msfoley/keyboard/keyboard.kicad_sch

## KiCad design keyboard.kicad_sch (2024-04-20)

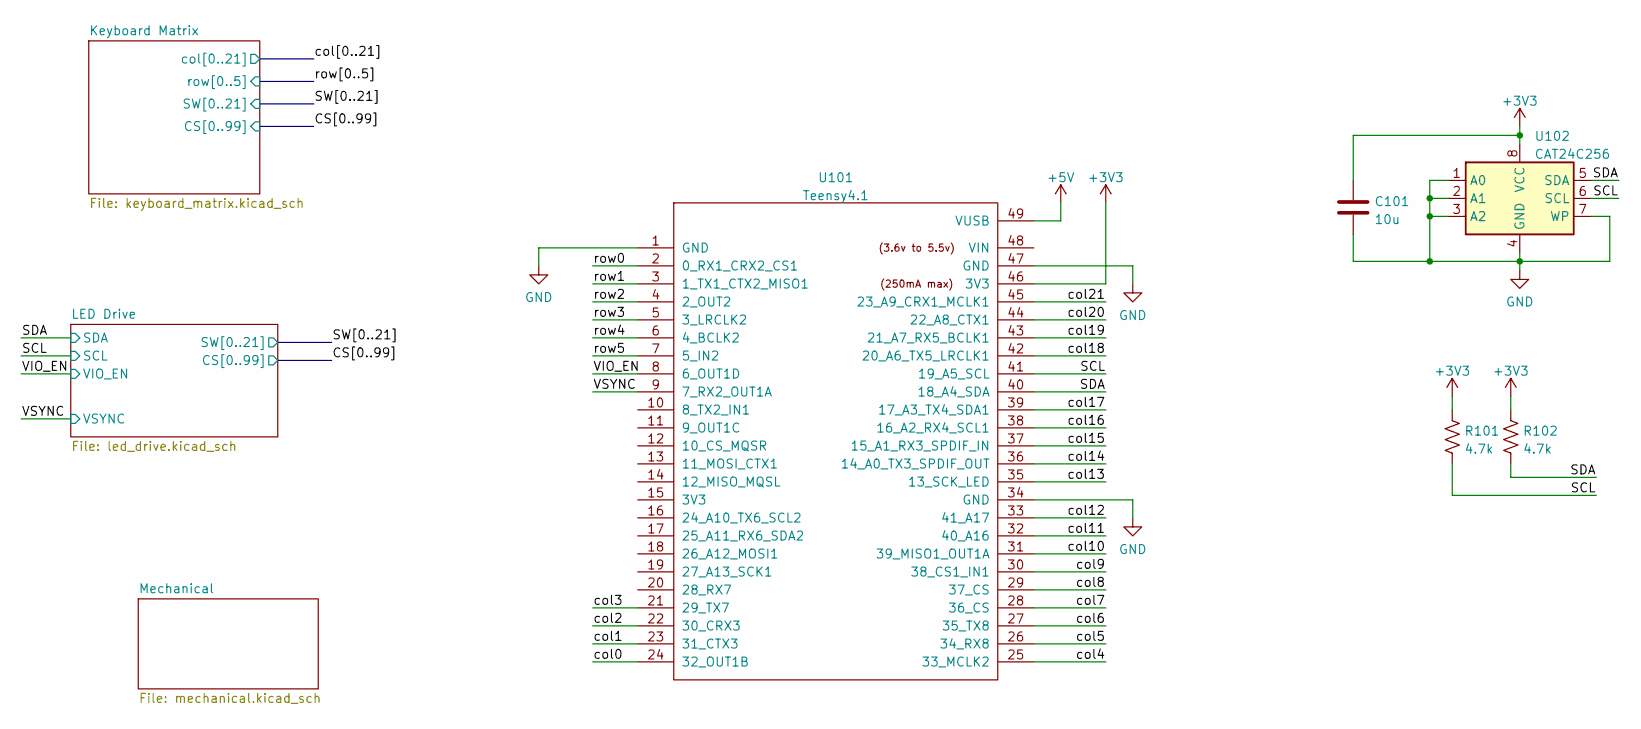
[picture p1: schematic keyboard.kicad_sch]

Parts:
C101: 10u; C_0805_2012Metric
R101, R102: 4.7k; R_0805_2012Metric
U101: Teensy4.1; Teensy41
U102: CAT24C256; TSSOP-8_4.4x3mm_P0.65mm

Connections:
+3V3: C101.1, R101.1, R102.1, U101.46 (3V3), U102.8 (VCC)
+5V: U101.49 (VUSB)
GND: C101.2, U101.1 (GND), U101.34 (GND), U101.47 (GND), U102.1 (A0), U102.2 (A1), U102.3 (A2), U102.4 (GND), U102.7 (WP)
SCL: R101.2, U101.41 (19_A5_SCL), U102.6 (SCL)
SDA: R102.2, U101.40 (18_A4_SDA), U102.5 (SDA)
VIO_EN: U101.8 (6_OUT1D)
VSYNC: U101.9 (7_RX2_OUT1A)
col0: U101.24 (32_OUT1B)
col1: U101.23 (31_CTX3)
col2: U101.22 (30_CRX3)
col3: U101.21 (29_TX7)
col4: U101.25 (33_MCLK2)
col5: U101.26 (34_RX8)
col6: U101.27 (35_TX8)
col7: U101.28 (36_CS)
col8: U101.29 (37_CS)
col9: U101.30 (38_CS1_IN1)
col10: U101.31 (39_MISO1_OUT1A)
col11: U101.32 (40_A16)
col12: U101.33 (41_A17)
col13: U101.35 (13_SCK_LED)
col14: U101.36 (14_A0_TX3_SPDIF_OUT)
col15: U101.37 (15_A1_RX3_SPDIF_IN)
col16: U101.38 (16_A2_RX4_SCL1)
col17: U101.39 (17_A3_TX4_SDA1)
col18: U101.42 (20_A6_TX5_LRCLK1)
col19: U101.43 (21_A7_RX5_BCLK1)
col20: U101.44 (22_A8_CTX1)
col21: U101.45 (23_A9_CRX1_MCLK1)
row0: U101.2 (0_RX1_CRX2_CS1)
row1: U101.3 (1_TX1_CTX2_MISO1)
row2: U101.4 (2_OUT2)
row3: U101.5 (3_LRCLK2)
row4: U101.6 (4_BCLK2)
row5: U101.7 (5_IN2)
