msfoley/keyboard/keyboard_matrix.kicad_sch

## KiCad design keyboard_matrix.kicad_sch (2024-04-20)

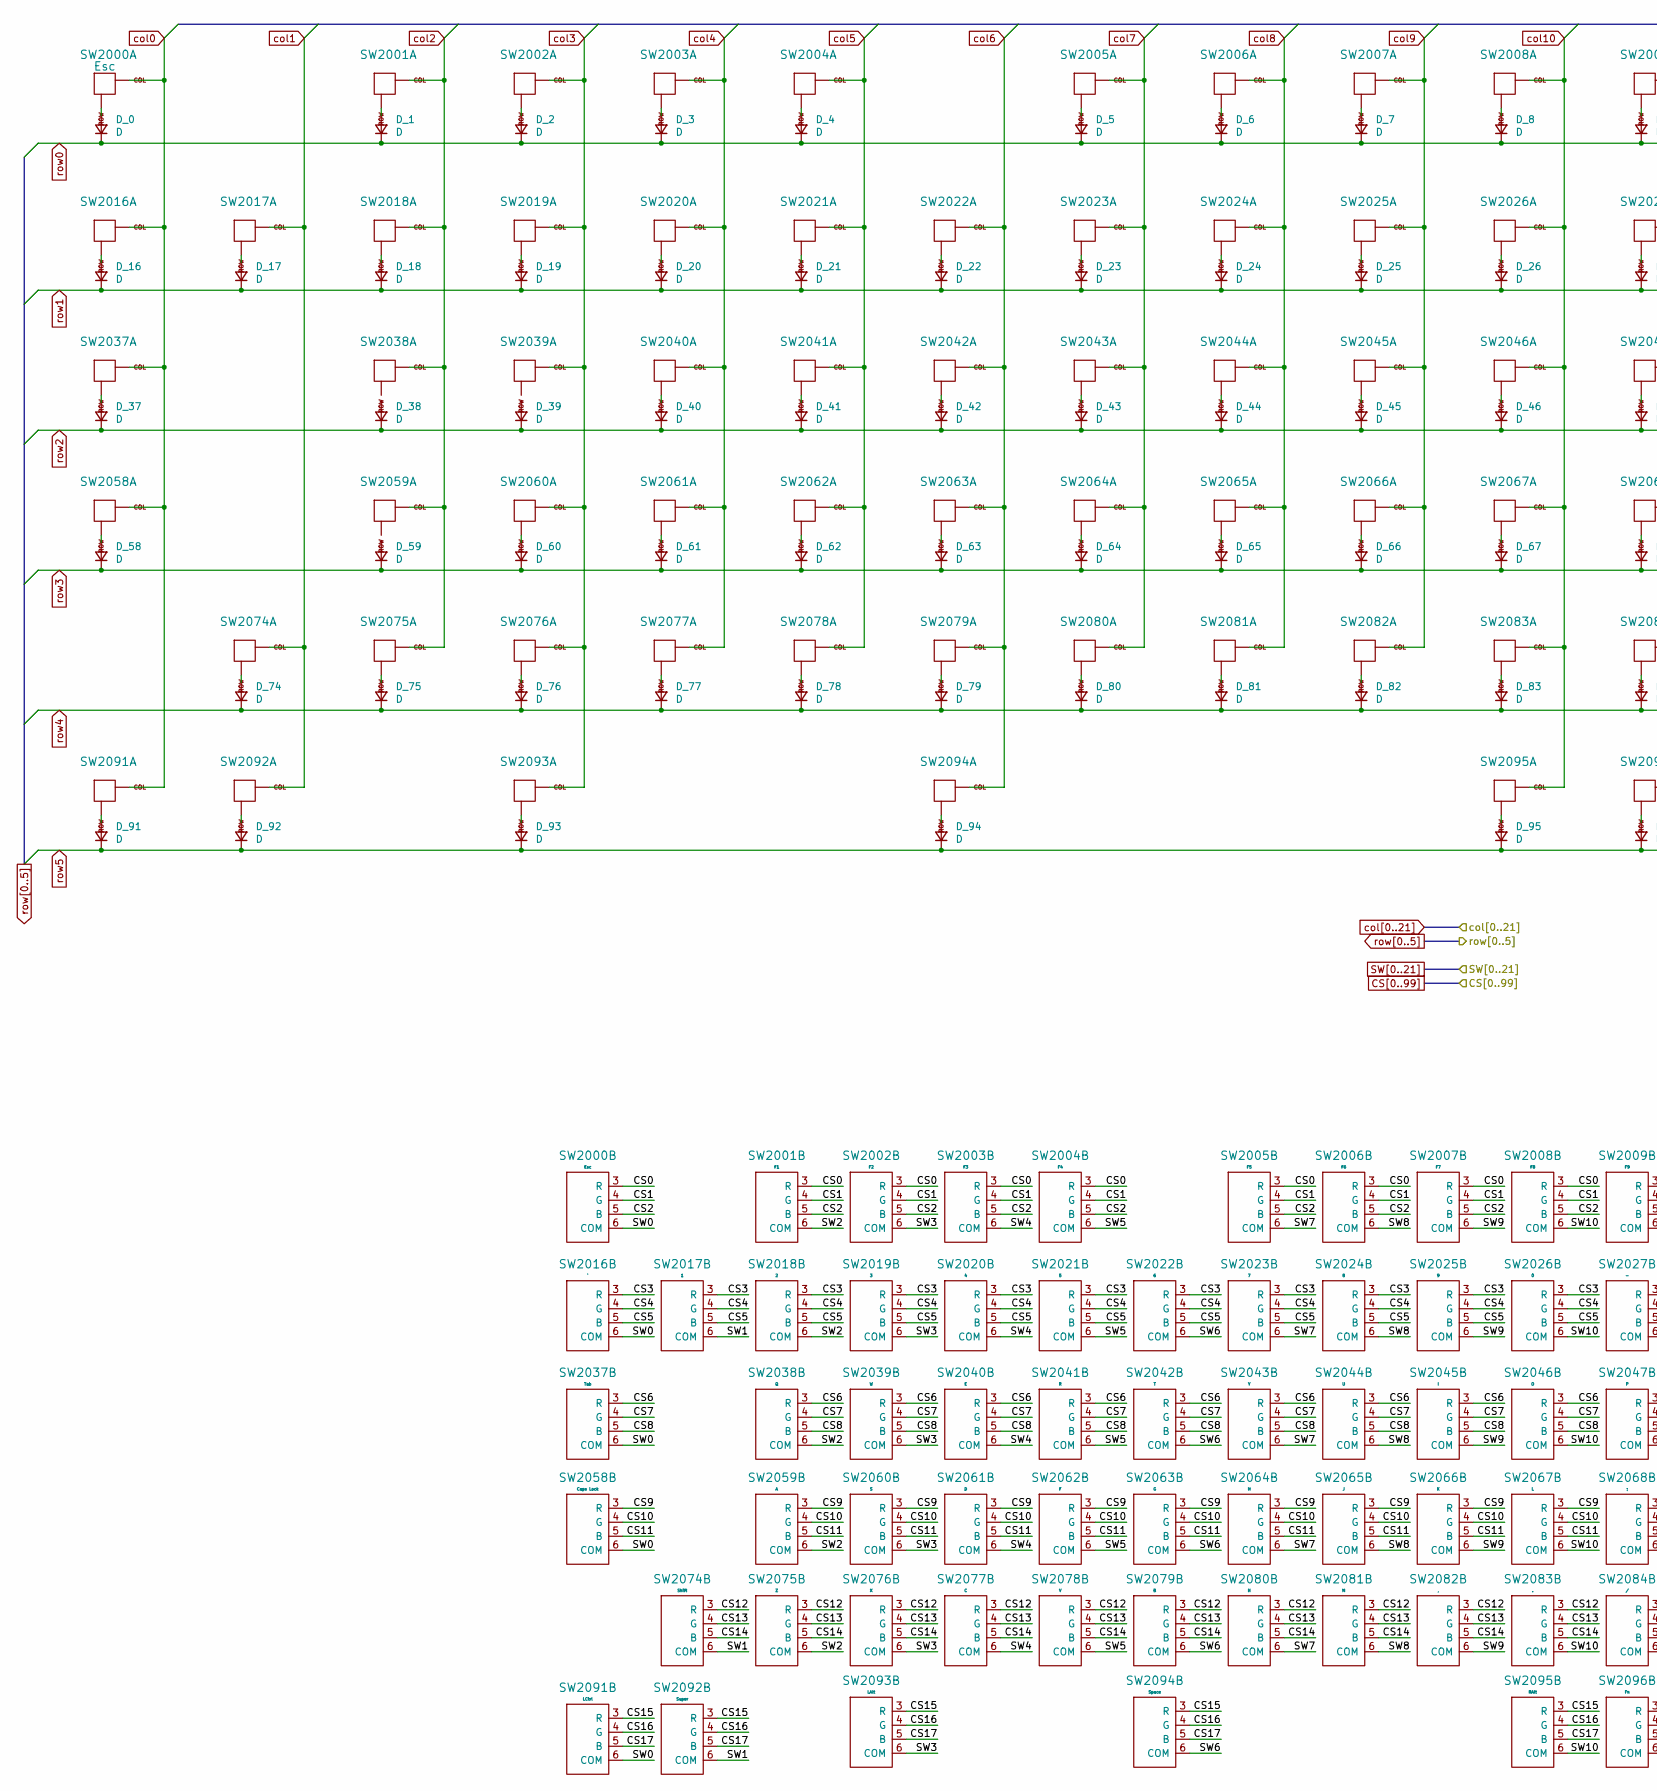
[picture p2: schematic keyboard_matrix.kicad_sch, part in row 1, column 1]

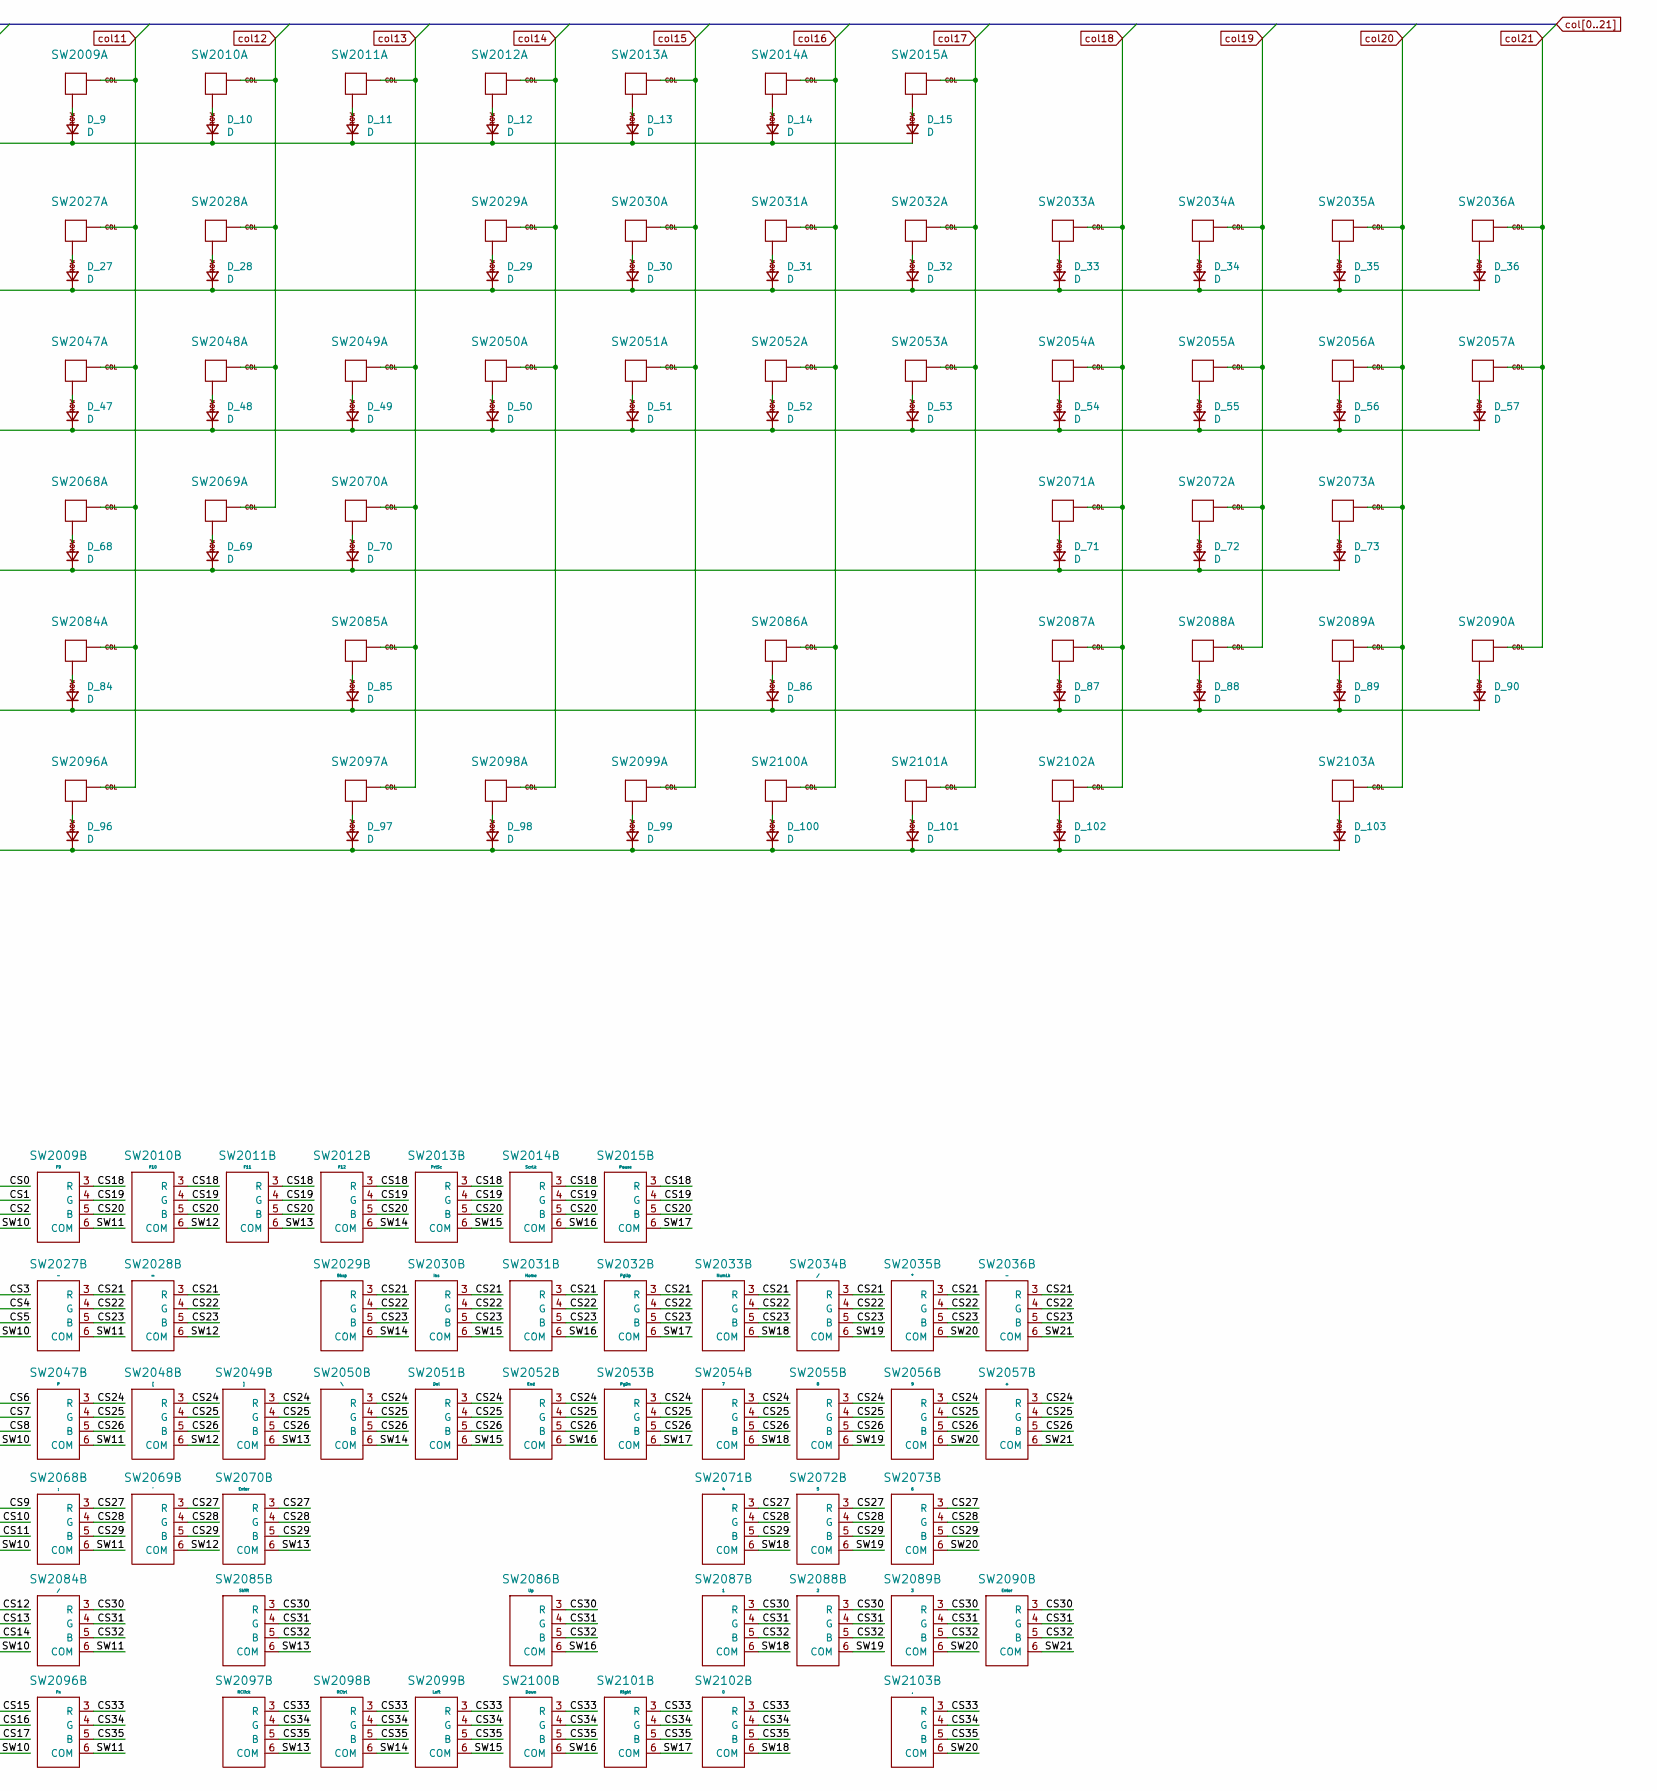
[picture p3: schematic keyboard_matrix.kicad_sch, part in row 1, column 2]

Parts:
D_0, D_1, D_2, D_3, D_4, D_5, D_6, D_7, D_8, D_9, D_10, D_11, D_12, D_13, D_14, D_15, D_16, D_17, D_18, D_19, D_20, D_21, D_22, D_23, D_24, D_25, D_26, D_27, D_28, D_29, D_30, D_31, D_32, D_33, D_34, D_35, D_36, D_37, D_38, D_39, D_40, D_41, D_42, D_43, D_44, D_45, D_46, D_47, D_48, D_49, D_50, D_51, D_52, D_53, D_54, D_55, D_56, D_57, D_58, D_59, D_60, D_61, D_62, D_63, D_64, D_65, D_66, D_67, D_68, D_69, D_70, D_71, D_72, D_73, D_74, D_75, D_76, D_77, D_78, D_79, D_80, D_81, D_82, D_83, D_84, D_85, D_86, D_87, D_88, D_89, D_90, D_91, D_92, D_93, D_94, D_95, D_96, D_97, D_98, D_99, D_100, D_101, D_102, D_103: D; D_SOD-123
SW2000: Esc; MXOnly-1U-Hotswap
SW2001: F1; MXOnly-1U-Hotswap
SW2002: F2; MXOnly-1U-Hotswap
SW2003: F3; MXOnly-1U-Hotswap
SW2004: F4; MXOnly-1U-Hotswap
SW2005: F5; MXOnly-1U-Hotswap
SW2006: F6; MXOnly-1U-Hotswap
SW2007: F7; MXOnly-1U-Hotswap
SW2008: F8; MXOnly-1U-Hotswap
SW2009: F9; MXOnly-1U-Hotswap
SW2010: F10; MXOnly-1U-Hotswap
SW2011: F11; MXOnly-1U-Hotswap
SW2012: F12; MXOnly-1U-Hotswap
SW2013: PrtSc; MXOnly-1U-Hotswap
SW2014: ScrLk; MXOnly-1U-Hotswap
SW2015: Pause; MXOnly-1U-Hotswap
SW2016: `; MXOnly-1U-Hotswap
SW2017, SW2087: 1; MXOnly-1U-Hotswap
SW2018, SW2088: 2; MXOnly-1U-Hotswap
SW2019, SW2089: 3; MXOnly-1U-Hotswap
SW2020, SW2071: 4; MXOnly-1U-Hotswap
SW2021, SW2072: 5; MXOnly-1U-Hotswap
SW2022, SW2073: 6; MXOnly-1U-Hotswap
SW2023, SW2054: 7; MXOnly-1U-Hotswap
SW2024, SW2055: 8; MXOnly-1U-Hotswap
SW2025, SW2056: 9; MXOnly-1U-Hotswap
SW2026, SW2102: 0; MXOnly-1U-Hotswap
SW2027, SW2036: -; MXOnly-1U-Hotswap
SW2028: =; MXOnly-1U-Hotswap
SW2029: Bksp; MXOnly-2U-Hotswap
SW2030: Ins; MXOnly-1U-Hotswap
SW2031: Home; MXOnly-1U-Hotswap
SW2032: PgUp; MXOnly-1U-Hotswap
SW2033: NumLk; MXOnly-1U-Hotswap
SW2034, SW2084: /; MXOnly-1U-Hotswap
SW2035: *; MXOnly-1U-Hotswap
SW2037: Tab; MXOnly-1.5U-Hotswap
SW2038: Q; MXOnly-1U-Hotswap
SW2039: W; MXOnly-1U-Hotswap
SW2040: E; MXOnly-1U-Hotswap
SW2041: R; MXOnly-1U-Hotswap
SW2042: T; MXOnly-1U-Hotswap
SW2043: Y; MXOnly-1U-Hotswap
SW2044: U; MXOnly-1U-Hotswap
SW2045: I; MXOnly-1U-Hotswap
SW2046: O; MXOnly-1U-Hotswap
SW2047: P; MXOnly-1U-Hotswap
SW2048: [; MXOnly-1U-Hotswap
SW2049: ]; MXOnly-1U-Hotswap
SW2050: \; MXOnly-1.5U-Hotswap
SW2051: Del; MXOnly-1U-Hotswap
SW2052: End; MXOnly-1U-Hotswap
SW2053: PgDn; MXOnly-1U-Hotswap
SW2057: +; MXOnly-2U-Hotswap
SW2058: Caps Lock; MXOnly-1.75U-Hotswap
SW2059: A; MXOnly-1U-Hotswap
SW2060: S; MXOnly-1U-Hotswap
SW2061: D; MXOnly-1U-Hotswap
SW2062: F; MXOnly-1U-Hotswap
SW2063: G; MXOnly-1U-Hotswap
SW2064: H; MXOnly-1U-Hotswap
SW2065: J; MXOnly-1U-Hotswap
SW2066: K; MXOnly-1U-Hotswap
SW2067: L; MXOnly-1U-Hotswap
SW2068: ;; MXOnly-1U-Hotswap
SW2069: '; MXOnly-1U-Hotswap
SW2070: Enter; MXOnly-2.25U-Hotswap
SW2074: Shift; MXOnly-2.25U-Hotswap
SW2075: Z; MXOnly-1U-Hotswap
SW2076: X; MXOnly-1U-Hotswap
SW2077: C; MXOnly-1U-Hotswap
SW2078: V; MXOnly-1U-Hotswap
SW2079: B; MXOnly-1U-Hotswap
SW2080: N; MXOnly-1U-Hotswap
SW2081: M; MXOnly-1U-Hotswap
SW2082: ,; MXOnly-1U-Hotswap
SW2083, SW2103: .; MXOnly-1U-Hotswap
SW2085: Shift; MXOnly-2.75U-Hotswap
SW2086: Up; MXOnly-1U-Hotswap
SW2090: Enter; MXOnly-2U-Hotswap
SW2091: LCtrl; MXOnly-1U-Hotswap
SW2092: Super; MXOnly-1U-Hotswap
SW2093: LAlt; MXOnly-1U-Hotswap
SW2094: Space; MXOnly-6.25U-Hotswap
SW2095: RAlt; MXOnly-1U-Hotswap
SW2096: Fn; MXOnly-1U-Hotswap
SW2097: RClick; MXOnly-1U-Hotswap
SW2098: RCtrl; MXOnly-1U-Hotswap
SW2099: Left; MXOnly-1U-Hotswap
SW2100: Down; MXOnly-1U-Hotswap
SW2101: Right; MXOnly-1U-Hotswap

Connections:
CS0: SW2000.3 (R), SW2001.3 (R), SW2002.3 (R), SW2003.3 (R), SW2004.3 (R), SW2005.3 (R), SW2006.3 (R), SW2007.3 (R), SW2008.3 (R)
CS1: SW2000.4 (G), SW2001.4 (G), SW2002.4 (G), SW2003.4 (G), SW2004.4 (G), SW2005.4 (G), SW2006.4 (G), SW2007.4 (G), SW2008.4 (G)
CS2: SW2000.5 (B), SW2001.5 (B), SW2002.5 (B), SW2003.5 (B), SW2004.5 (B), SW2005.5 (B), SW2006.5 (B), SW2007.5 (B), SW2008.5 (B)
CS3: SW2016.3 (R), SW2017.3 (R), SW2018.3 (R), SW2019.3 (R), SW2020.3 (R), SW2021.3 (R), SW2022.3 (R), SW2023.3 (R), SW2024.3 (R), SW2025.3 (R), SW2026.3 (R)
CS4: SW2016.4 (G), SW2017.4 (G), SW2018.4 (G), SW2019.4 (G), SW2020.4 (G), SW2021.4 (G), SW2022.4 (G), SW2023.4 (G), SW2024.4 (G), SW2025.4 (G), SW2026.4 (G)
CS5: SW2016.5 (B), SW2017.5 (B), SW2018.5 (B), SW2019.5 (B), SW2020.5 (B), SW2021.5 (B), SW2022.5 (B), SW2023.5 (B), SW2024.5 (B), SW2025.5 (B), SW2026.5 (B)
CS6: SW2037.3 (R), SW2038.3 (R), SW2039.3 (R), SW2040.3 (R), SW2041.3 (R), SW2042.3 (R), SW2043.3 (R), SW2044.3 (R), SW2045.3 (R), SW2046.3 (R)
CS7: SW2037.4 (G), SW2038.4 (G), SW2039.4 (G), SW2040.4 (G), SW2041.4 (G), SW2042.4 (G), SW2043.4 (G), SW2044.4 (G), SW2045.4 (G), SW2046.4 (G)
CS8: SW2037.5 (B), SW2038.5 (B), SW2039.5 (B), SW2040.5 (B), SW2041.5 (B), SW2042.5 (B), SW2043.5 (B), SW2044.5 (B), SW2045.5 (B), SW2046.5 (B)
CS9: SW2058.3 (R), SW2059.3 (R), SW2060.3 (R), SW2061.3 (R), SW2062.3 (R), SW2063.3 (R), SW2064.3 (R), SW2065.3 (R), SW2066.3 (R), SW2067.3 (R)
CS10: SW2058.4 (G), SW2059.4 (G), SW2060.4 (G), SW2061.4 (G), SW2062.4 (G), SW2063.4 (G), SW2064.4 (G), SW2065.4 (G), SW2066.4 (G), SW2067.4 (G)
CS11: SW2058.5 (B), SW2059.5 (B), SW2060.5 (B), SW2061.5 (B), SW2062.5 (B), SW2063.5 (B), SW2064.5 (B), SW2065.5 (B), SW2066.5 (B), SW2067.5 (B)
CS12: SW2074.3 (R), SW2075.3 (R), SW2076.3 (R), SW2077.3 (R), SW2078.3 (R), SW2079.3 (R), SW2080.3 (R), SW2081.3 (R), SW2082.3 (R), SW2083.3 (R)
CS13: SW2074.4 (G), SW2075.4 (G), SW2076.4 (G), SW2077.4 (G), SW2078.4 (G), SW2079.4 (G), SW2080.4 (G), SW2081.4 (G), SW2082.4 (G), SW2083.4 (G)
CS14: SW2074.5 (B), SW2075.5 (B), SW2076.5 (B), SW2077.5 (B), SW2078.5 (B), SW2079.5 (B), SW2080.5 (B), SW2081.5 (B), SW2082.5 (B), SW2083.5 (B)
CS15: SW2091.3 (R), SW2092.3 (R), SW2093.3 (R), SW2094.3 (R), SW2095.3 (R)
CS16: SW2091.4 (G), SW2092.4 (G), SW2093.4 (G), SW2094.4 (G), SW2095.4 (G)
CS17: SW2091.5 (B), SW2092.5 (B), SW2093.5 (B), SW2094.5 (B), SW2095.5 (B)
CS18: SW2009.3 (R), SW2010.3 (R), SW2011.3 (R), SW2012.3 (R), SW2013.3 (R), SW2014.3 (R), SW2015.3 (R)
CS19: SW2009.4 (G), SW2010.4 (G), SW2011.4 (G), SW2012.4 (G), SW2013.4 (G), SW2014.4 (G), SW2015.4 (G)
CS20: SW2009.5 (B), SW2010.5 (B), SW2011.5 (B), SW2012.5 (B), SW2013.5 (B), SW2014.5 (B), SW2015.5 (B)
CS21: SW2027.3 (R), SW2028.3 (R), SW2029.3 (R), SW2030.3 (R), SW2031.3 (R), SW2032.3 (R), SW2033.3 (R), SW2034.3 (R), SW2035.3 (R), SW2036.3 (R)
CS22: SW2027.4 (G), SW2028.4 (G), SW2029.4 (G), SW2030.4 (G), SW2031.4 (G), SW2032.4 (G), SW2033.4 (G), SW2034.4 (G), SW2035.4 (G), SW2036.4 (G)
CS23: SW2027.5 (B), SW2028.5 (B), SW2029.5 (B), SW2030.5 (B), SW2031.5 (B), SW2032.5 (B), SW2033.5 (B), SW2034.5 (B), SW2035.5 (B), SW2036.5 (B)
CS24: SW2047.3 (R), SW2048.3 (R), SW2049.3 (R), SW2050.3 (R), SW2051.3 (R), SW2052.3 (R), SW2053.3 (R), SW2054.3 (R), SW2055.3 (R), SW2056.3 (R), SW2057.3 (R)
CS25: SW2047.4 (G), SW2048.4 (G), SW2049.4 (G), SW2050.4 (G), SW2051.4 (G), SW2052.4 (G), SW2053.4 (G), SW2054.4 (G), SW2055.4 (G), SW2056.4 (G), SW2057.4 (G)
CS26: SW2047.5 (B), SW2048.5 (B), SW2049.5 (B), SW2050.5 (B), SW2051.5 (B), SW2052.5 (B), SW2053.5 (B), SW2054.5 (B), SW2055.5 (B), SW2056.5 (B), SW2057.5 (B)
CS27: SW2068.3 (R), SW2069.3 (R), SW2070.3 (R), SW2071.3 (R), SW2072.3 (R), SW2073.3 (R)
CS28: SW2068.4 (G), SW2069.4 (G), SW2070.4 (G), SW2071.4 (G), SW2072.4 (G), SW2073.4 (G)
CS29: SW2068.5 (B), SW2069.5 (B), SW2070.5 (B), SW2071.5 (B), SW2072.5 (B), SW2073.5 (B)
CS30: SW2084.3 (R), SW2085.3 (R), SW2086.3 (R), SW2087.3 (R), SW2088.3 (R), SW2089.3 (R), SW2090.3 (R)
CS31: SW2084.4 (G), SW2085.4 (G), SW2086.4 (G), SW2087.4 (G), SW2088.4 (G), SW2089.4 (G), SW2090.4 (G)
CS32: SW2084.5 (B), SW2085.5 (B), SW2086.5 (B), SW2087.5 (B), SW2088.5 (B), SW2089.5 (B), SW2090.5 (B)
CS33: SW2096.3 (R), SW2097.3 (R), SW2098.3 (R), SW2099.3 (R), SW2100.3 (R), SW2101.3 (R), SW2102.3 (R), SW2103.3 (R)
CS34: SW2096.4 (G), SW2097.4 (G), SW2098.4 (G), SW2099.4 (G), SW2100.4 (G), SW2101.4 (G), SW2102.4 (G), SW2103.4 (G)
CS35: SW2096.5 (B), SW2097.5 (B), SW2098.5 (B), SW2099.5 (B), SW2100.5 (B), SW2101.5 (B), SW2102.5 (B), SW2103.5 (B)
unnamed: D_0.2 (A), SW2000.2 (ROW)
unnamed: D_1.2 (A), SW2001.2 (ROW)
unnamed: D_2.2 (A), SW2002.2 (ROW)
unnamed: D_3.2 (A), SW2003.2 (ROW)
unnamed: D_4.2 (A), SW2004.2 (ROW)
unnamed: D_5.2 (A), SW2005.2 (ROW)
unnamed: D_6.2 (A), SW2006.2 (ROW)
unnamed: D_7.2 (A), SW2007.2 (ROW)
unnamed: D_8.2 (A), SW2008.2 (ROW)
unnamed: D_9.2 (A), SW2009.2 (ROW)
unnamed: D_10.2 (A), SW2010.2 (ROW)
unnamed: D_11.2 (A), SW2011.2 (ROW)
unnamed: D_12.2 (A), SW2012.2 (ROW)
unnamed: D_13.2 (A), SW2013.2 (ROW)
unnamed: D_14.2 (A), SW2014.2 (ROW)
unnamed: D_15.2 (A), SW2015.2 (ROW)
unnamed: D_16.2 (A), SW2016.2 (ROW)
unnamed: D_17.2 (A), SW2017.2 (ROW)
unnamed: D_18.2 (A), SW2018.2 (ROW)
unnamed: D_19.2 (A), SW2019.2 (ROW)
unnamed: D_20.2 (A), SW2020.2 (ROW)
unnamed: D_21.2 (A), SW2021.2 (ROW)
unnamed: D_22.2 (A), SW2022.2 (ROW)
unnamed: D_23.2 (A), SW2023.2 (ROW)
unnamed: D_24.2 (A), SW2024.2 (ROW)
unnamed: D_25.2 (A), SW2025.2 (ROW)
unnamed: D_26.2 (A), SW2026.2 (ROW)
unnamed: D_27.2 (A), SW2027.2 (ROW)
unnamed: D_28.2 (A), SW2028.2 (ROW)
unnamed: D_29.2 (A), SW2029.2 (ROW)
unnamed: D_30.2 (A), SW2030.2 (ROW)
unnamed: D_31.2 (A), SW2031.2 (ROW)
unnamed: D_32.2 (A), SW2032.2 (ROW)
unnamed: D_33.2 (A), SW2033.2 (ROW)
unnamed: D_34.2 (A), SW2034.2 (ROW)
unnamed: D_35.2 (A), SW2035.2 (ROW)
unnamed: D_36.2 (A), SW2036.2 (ROW)
unnamed: D_37.2 (A), SW2037.2 (ROW)
unnamed: D_40.2 (A), SW2040.2 (ROW)
unnamed: D_41.2 (A), SW2041.2 (ROW)
unnamed: D_42.2 (A), SW2042.2 (ROW)
unnamed: D_43.2 (A), SW2043.2 (ROW)
unnamed: D_44.2 (A), SW2044.2 (ROW)
unnamed: D_45.2 (A), SW2045.2 (ROW)
unnamed: D_46.2 (A), SW2046.2 (ROW)
unnamed: D_47.2 (A), SW2047.2 (ROW)
unnamed: D_48.2 (A), SW2048.2 (ROW)
unnamed: D_49.2 (A), SW2049.2 (ROW)
unnamed: D_50.2 (A), SW2050.2 (ROW)
unnamed: D_51.2 (A), SW2051.2 (ROW)
unnamed: D_52.2 (A), SW2052.2 (ROW)
unnamed: D_53.2 (A), SW2053.2 (ROW)
unnamed: D_54.2 (A), SW2054.2 (ROW)
unnamed: D_55.2 (A), SW2055.2 (ROW)
unnamed: D_56.2 (A), SW2056.2 (ROW)
unnamed: D_57.2 (A), SW2057.2 (ROW)
unnamed: D_58.2 (A), SW2058.2 (ROW)
unnamed: D_60.2 (A), SW2060.2 (ROW)
unnamed: D_61.2 (A), SW2061.2 (ROW)
unnamed: D_62.2 (A), SW2062.2 (ROW)
unnamed: D_63.2 (A), SW2063.2 (ROW)
unnamed: D_64.2 (A), SW2064.2 (ROW)
unnamed: D_65.2 (A), SW2065.2 (ROW)
unnamed: D_66.2 (A), SW2066.2 (ROW)
unnamed: D_67.2 (A), SW2067.2 (ROW)
unnamed: D_68.2 (A), SW2068.2 (ROW)
unnamed: D_69.2 (A), SW2069.2 (ROW)
unnamed: D_70.2 (A), SW2070.2 (ROW)
unnamed: D_71.2 (A), SW2071.2 (ROW)
unnamed: D_72.2 (A), SW2072.2 (ROW)
unnamed: D_73.2 (A), SW2073.2 (ROW)
unnamed: D_74.2 (A), SW2074.2 (ROW)
unnamed: D_75.2 (A), SW2075.2 (ROW)
unnamed: D_76.2 (A), SW2076.2 (ROW)
unnamed: D_77.2 (A), SW2077.2 (ROW)
unnamed: D_78.2 (A), SW2078.2 (ROW)
unnamed: D_79.2 (A), SW2079.2 (ROW)
unnamed: D_80.2 (A), SW2080.2 (ROW)
unnamed: D_81.2 (A), SW2081.2 (ROW)
unnamed: D_82.2 (A), SW2082.2 (ROW)
unnamed: D_83.2 (A), SW2083.2 (ROW)
unnamed: D_84.2 (A), SW2084.2 (ROW)
unnamed: D_85.2 (A), SW2085.2 (ROW)
unnamed: D_86.2 (A), SW2086.2 (ROW)
unnamed: D_87.2 (A), SW2087.2 (ROW)
unnamed: D_88.2 (A), SW2088.2 (ROW)
unnamed: D_89.2 (A), SW2089.2 (ROW)
unnamed: D_90.2 (A), SW2090.2 (ROW)
unnamed: D_91.2 (A), SW2091.2 (ROW)
unnamed: D_92.2 (A), SW2092.2 (ROW)
unnamed: D_93.2 (A), SW2093.2 (ROW)
unnamed: D_94.2 (A), SW2094.2 (ROW)
unnamed: D_95.2 (A), SW2095.2 (ROW)
unnamed: D_96.2 (A), SW2096.2 (ROW)
unnamed: D_97.2 (A), SW2097.2 (ROW)
unnamed: D_98.2 (A), SW2098.2 (ROW)
unnamed: D_99.2 (A), SW2099.2 (ROW)
unnamed: D_100.2 (A), SW2100.2 (ROW)
unnamed: D_101.2 (A), SW2101.2 (ROW)
unnamed: D_102.2 (A), SW2102.2 (ROW)
unnamed: D_103.2 (A), SW2103.2 (ROW)
SW0: SW2000.6 (COM), SW2016.6 (COM), SW2037.6 (COM), SW2058.6 (COM), SW2091.6 (COM)
SW1: SW2017.6 (COM), SW2074.6 (COM), SW2092.6 (COM)
SW2: SW2001.6 (COM), SW2018.6 (COM), SW2038.6 (COM), SW2059.6 (COM), SW2075.6 (COM)
SW3: SW2002.6 (COM), SW2019.6 (COM), SW2039.6 (COM), SW2060.6 (COM), SW2076.6 (COM), SW2093.6 (COM)
SW4: SW2003.6 (COM), SW2020.6 (COM), SW2040.6 (COM), SW2061.6 (COM), SW2077.6 (COM)
SW5: SW2004.6 (COM), SW2021.6 (COM), SW2041.6 (COM), SW2062.6 (COM), SW2078.6 (COM)
SW6: SW2022.6 (COM), SW2042.6 (COM), SW2063.6 (COM), SW2079.6 (COM), SW2094.6 (COM)
SW7: SW2005.6 (COM), SW2023.6 (COM), SW2043.6 (COM), SW2064.6 (COM), SW2080.6 (COM)
SW8: SW2006.6 (COM), SW2024.6 (COM), SW2044.6 (COM), SW2065.6 (COM), SW2081.6 (COM)
SW9: SW2007.6 (COM), SW2025.6 (COM), SW2045.6 (COM), SW2066.6 (COM), SW2082.6 (COM)
SW10: SW2008.6 (COM), SW2026.6 (COM), SW2046.6 (COM), SW2067.6 (COM), SW2083.6 (COM), SW2095.6 (COM)
SW11: SW2009.6 (COM), SW2027.6 (COM), SW2047.6 (COM), SW2068.6 (COM), SW2084.6 (COM), SW2096.6 (COM)
SW12: SW2010.6 (COM), SW2028.6 (COM), SW2048.6 (COM), SW2069.6 (COM)
SW13: SW2011.6 (COM), SW2049.6 (COM), SW2070.6 (COM), SW2085.6 (COM), SW2097.6 (COM)
SW14: SW2012.6 (COM), SW2029.6 (COM), SW2050.6 (COM), SW2098.6 (COM)
SW15: SW2013.6 (COM), SW2030.6 (COM), SW2051.6 (COM), SW2099.6 (COM)
SW16: SW2014.6 (COM), SW2031.6 (COM), SW2052.6 (COM), SW2086.6 (COM), SW2100.6 (COM)
SW17: SW2015.6 (COM), SW2032.6 (COM), SW2053.6 (COM), SW2101.6 (COM)
SW18: SW2033.6 (COM), SW2054.6 (COM), SW2071.6 (COM), SW2087.6 (COM), SW2102.6 (COM)
SW19: SW2034.6 (COM), SW2055.6 (COM), SW2072.6 (COM), SW2088.6 (COM)
SW20: SW2035.6 (COM), SW2056.6 (COM), SW2073.6 (COM), SW2089.6 (COM), SW2103.6 (COM)
SW21: SW2036.6 (COM), SW2057.6 (COM), SW2090.6 (COM)
col0: SW2000.1 (COL), SW2016.1 (COL), SW2037.1 (COL), SW2058.1 (COL), SW2091.1 (COL)
col1: SW2017.1 (COL), SW2074.1 (COL), SW2092.1 (COL)
col2: SW2001.1 (COL), SW2018.1 (COL), SW2038.1 (COL), SW2059.1 (COL), SW2075.1 (COL)
col3: SW2002.1 (COL), SW2019.1 (COL), SW2039.1 (COL), SW2060.1 (COL), SW2076.1 (COL), SW2093.1 (COL)
col4: SW2003.1 (COL), SW2020.1 (COL), SW2040.1 (COL), SW2061.1 (COL), SW2077.1 (COL)
col5: SW2004.1 (COL), SW2021.1 (COL), SW2041.1 (COL), SW2062.1 (COL), SW2078.1 (COL)
col6: SW2022.1 (COL), SW2042.1 (COL), SW2063.1 (COL), SW2079.1 (COL), SW2094.1 (COL)
col7: SW2005.1 (COL), SW2023.1 (COL), SW2043.1 (COL), SW2064.1 (COL), SW2080.1 (COL)
col8: SW2006.1 (COL), SW2024.1 (COL), SW2044.1 (COL), SW2065.1 (COL), SW2081.1 (COL)
col9: SW2007.1 (COL), SW2025.1 (COL), SW2045.1 (COL), SW2066.1 (COL), SW2082.1 (COL)
col10: SW2008.1 (COL), SW2026.1 (COL), SW2046.1 (COL), SW2067.1 (COL), SW2083.1 (COL), SW2095.1 (COL)
col11: SW2009.1 (COL), SW2027.1 (COL), SW2047.1 (COL), SW2068.1 (COL), SW2084.1 (COL), SW2096.1 (COL)
col12: SW2010.1 (COL), SW2028.1 (COL), SW2048.1 (COL), SW2069.1 (COL)
col13: SW2011.1 (COL), SW2049.1 (COL), SW2070.1 (COL), SW2085.1 (COL), SW2097.1 (COL)
col14: SW2012.1 (COL), SW2029.1 (COL), SW2050.1 (COL), SW2098.1 (COL)
col15: SW2013.1 (COL), SW2030.1 (COL), SW2051.1 (COL), SW2099.1 (COL)
col16: SW2014.1 (COL), SW2031.1 (COL), SW2052.1 (COL), SW2086.1 (COL), SW2100.1 (COL)
col17: SW2015.1 (COL), SW2032.1 (COL), SW2053.1 (COL), SW2101.1 (COL)
col18: SW2033.1 (COL), SW2054.1 (COL), SW2071.1 (COL), SW2087.1 (COL), SW2102.1 (COL)
col19: SW2034.1 (COL), SW2055.1 (COL), SW2072.1 (COL), SW2088.1 (COL)
col20: SW2035.1 (COL), SW2056.1 (COL), SW2073.1 (COL), SW2089.1 (COL), SW2103.1 (COL)
col21: SW2036.1 (COL), SW2057.1 (COL), SW2090.1 (COL)
row0: D_0.1 (K), D_1.1 (K), D_2.1 (K), D_3.1 (K), D_4.1 (K), D_5.1 (K), D_6.1 (K), D_7.1 (K), D_8.1 (K), D_9.1 (K), D_10.1 (K), D_11.1 (K), D_12.1 (K), D_13.1 (K), D_14.1 (K), D_15.1 (K)
row1: D_16.1 (K), D_17.1 (K), D_18.1 (K), D_19.1 (K), D_20.1 (K), D_21.1 (K), D_22.1 (K), D_23.1 (K), D_24.1 (K), D_25.1 (K), D_26.1 (K), D_27.1 (K), D_28.1 (K), D_29.1 (K), D_30.1 (K), D_31.1 (K), D_32.1 (K), D_33.1 (K), D_34.1 (K), D_35.1 (K), D_36.1 (K)
row2: D_37.1 (K), D_38.1 (K), D_39.1 (K), D_40.1 (K), D_41.1 (K), D_42.1 (K), D_43.1 (K), D_44.1 (K), D_45.1 (K), D_46.1 (K), D_47.1 (K), D_48.1 (K), D_49.1 (K), D_50.1 (K), D_51.1 (K), D_52.1 (K), D_53.1 (K), D_54.1 (K), D_55.1 (K), D_56.1 (K), D_57.1 (K)
row3: D_58.1 (K), D_59.1 (K), D_60.1 (K), D_61.1 (K), D_62.1 (K), D_63.1 (K), D_64.1 (K), D_65.1 (K), D_66.1 (K), D_67.1 (K), D_68.1 (K), D_69.1 (K), D_70.1 (K), D_71.1 (K), D_72.1 (K), D_73.1 (K)
row4: D_74.1 (K), D_75.1 (K), D_76.1 (K), D_77.1 (K), D_78.1 (K), D_79.1 (K), D_80.1 (K), D_81.1 (K), D_82.1 (K), D_83.1 (K), D_84.1 (K), D_85.1 (K), D_86.1 (K), D_87.1 (K), D_88.1 (K), D_89.1 (K), D_90.1 (K)
row5: D_91.1 (K), D_92.1 (K), D_93.1 (K), D_94.1 (K), D_95.1 (K), D_96.1 (K), D_97.1 (K), D_98.1 (K), D_99.1 (K), D_100.1 (K), D_101.1 (K), D_102.1 (K), D_103.1 (K)
