msfoley/keyboard/led_drive.kicad_sch

## KiCad design led_drive.kicad_sch (2024-04-20)

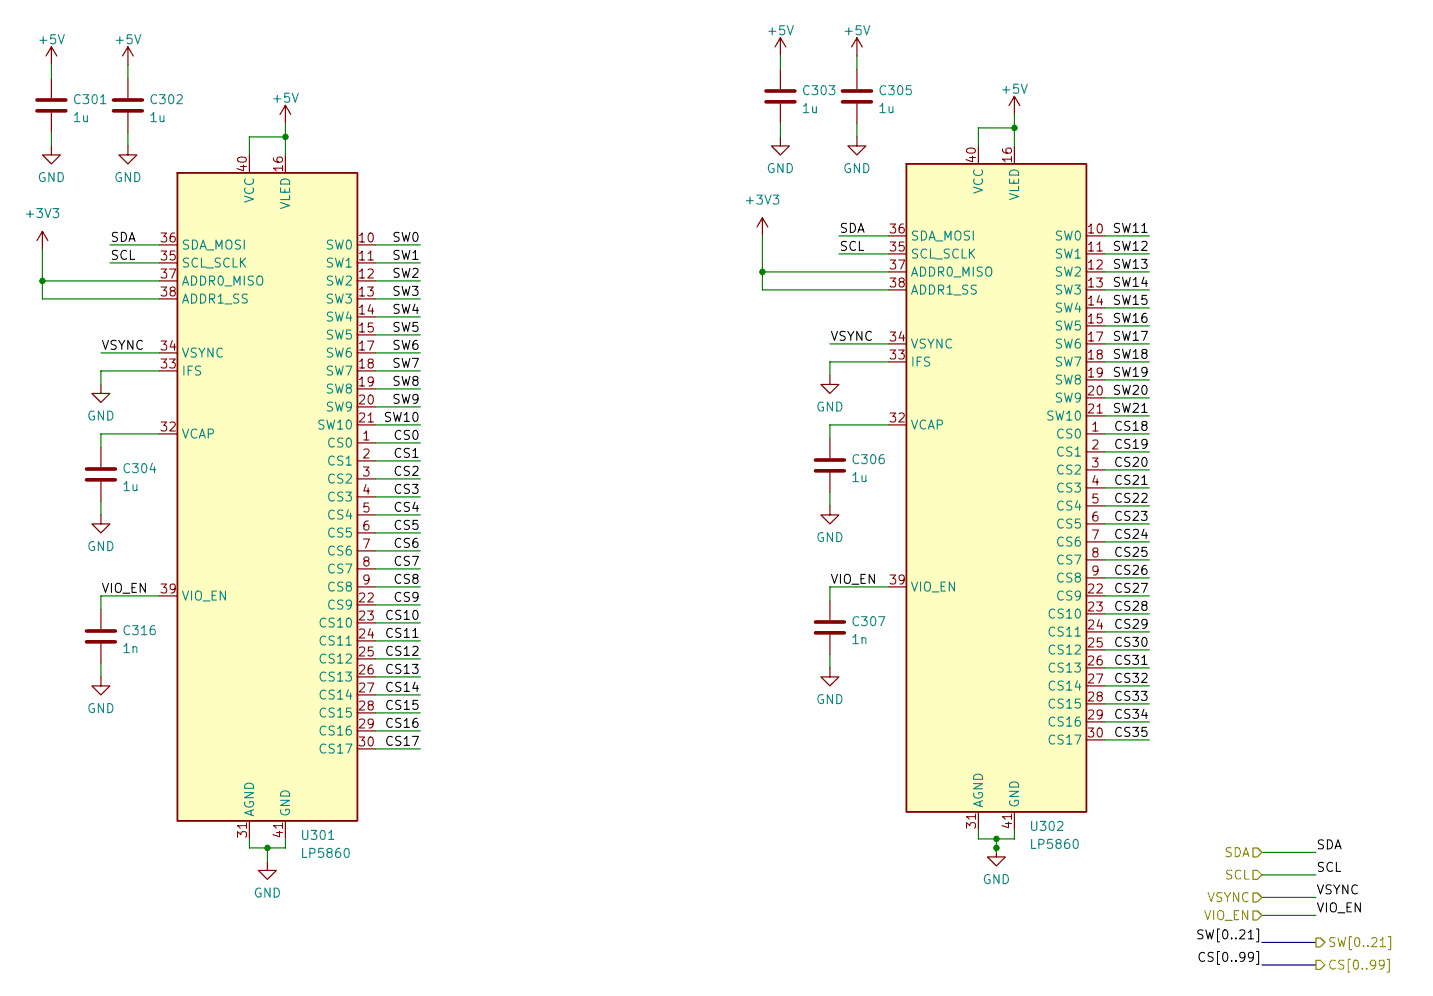
[picture p4: schematic led_drive.kicad_sch]

Parts:
C301, C302, C303, C304, C305, C306: 1u; C_0603_1608Metric
C307, C316: 1n; C_0603_1608Metric
U301, U302: LP5860; QFN-40-1EP_5x5mm_P0.4mm_EP3.8x3.8mm_ThermalVias

Connections:
+3V3: U301.37 (ADDR0_MISO), U301.38 (ADDR1_SS), U302.37 (ADDR0_MISO), U302.38 (ADDR1_SS)
+5V: C301.1, C302.1, C303.1, C305.1, U301.16 (VLED), U301.40 (VCC), U302.16 (VLED), U302.40 (VCC)
CS0: U301.1 (CS0)
CS1: U301.2 (CS1)
CS2: U301.3 (CS2)
CS3: U301.4 (CS3)
CS4: U301.5 (CS4)
CS5: U301.6 (CS5)
CS6: U301.7 (CS6)
CS7: U301.8 (CS7)
CS8: U301.9 (CS8)
CS9: U301.22 (CS9)
CS10: U301.23 (CS10)
CS11: U301.24 (CS11)
CS12: U301.25 (CS12)
CS13: U301.26 (CS13)
CS14: U301.27 (CS14)
CS15: U301.28 (CS15)
CS16: U301.29 (CS16)
CS17: U301.30 (CS17)
CS18: U302.1 (CS0)
CS19: U302.2 (CS1)
CS20: U302.3 (CS2)
CS21: U302.4 (CS3)
CS22: U302.5 (CS4)
CS23: U302.6 (CS5)
CS24: U302.7 (CS6)
CS25: U302.8 (CS7)
CS26: U302.9 (CS8)
CS27: U302.22 (CS9)
CS28: U302.23 (CS10)
CS29: U302.24 (CS11)
CS30: U302.25 (CS12)
CS31: U302.26 (CS13)
CS32: U302.27 (CS14)
CS33: U302.28 (CS15)
CS34: U302.29 (CS16)
CS35: U302.30 (CS17)
GND: C301.2, C302.2, C303.2, C304.2, C305.2, C306.2, C307.2, C316.2, U301.31 (AGND), U301.33 (IFS), U301.41 (GND), U302.31 (AGND), U302.33 (IFS), U302.41 (GND)
unnamed: C304.1, U301.32 (VCAP)
unnamed: C306.1, U302.32 (VCAP)
SCL: U301.35 (SCL_SCLK), U302.35 (SCL_SCLK)
SDA: U301.36 (SDA_MOSI), U302.36 (SDA_MOSI)
SW0: U301.10 (SW0)
SW1: U301.11 (SW1)
SW2: U301.12 (SW2)
SW3: U301.13 (SW3)
SW4: U301.14 (SW4)
SW5: U301.15 (SW5)
SW6: U301.17 (SW6)
SW7: U301.18 (SW7)
SW8: U301.19 (SW8)
SW9: U301.20 (SW9)
SW10: U301.21 (SW10)
SW11: U302.10 (SW0)
SW12: U302.11 (SW1)
SW13: U302.12 (SW2)
SW14: U302.13 (SW3)
SW15: U302.14 (SW4)
SW16: U302.15 (SW5)
SW17: U302.17 (SW6)
SW18: U302.18 (SW7)
SW19: U302.19 (SW8)
SW20: U302.20 (SW9)
SW21: U302.21 (SW10)
VIO_EN: C307.1, C316.1, U301.39 (VIO_EN), U302.39 (VIO_EN)
VSYNC: U301.34 (VSYNC), U302.34 (VSYNC)
