msfoley/keyboard/mechanical.kicad_sch

## KiCad design mechanical.kicad_sch (2024-04-20)

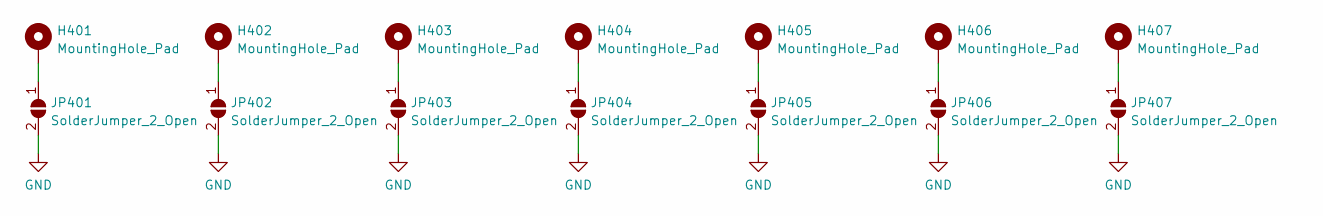
[picture p5: schematic mechanical.kicad_sch]

Parts:
H401, H402, H403, H404, H405, H406, H407: MountingHole_Pad; MountingHole_3.2mm_M3_Pad_Via
JP401, JP402, JP403, JP404, JP405, JP406, JP407: SolderJumper_2_Open; SolderJumper-2_P1.3mm_Open_Pad1.0x1.5mm

Connections:
GND: JP401.2 (B), JP402.2 (B), JP403.2 (B), JP404.2 (B), JP405.2 (B), JP406.2 (B), JP407.2 (B)
unnamed: H401.1, JP401.1 (A)
unnamed: H402.1, JP402.1 (A)
unnamed: H403.1, JP403.1 (A)
unnamed: H404.1, JP404.1 (A)
unnamed: H405.1, JP405.1 (A)
unnamed: H406.1, JP406.1 (A)
unnamed: H407.1, JP407.1 (A)
