msfoley/keyboard/(commit log)

2022-11-17 Initial board
    [keyboard.kicad_sch, keyboard.sch, keyboard_matrix.kicad_sch, led_drive.kicad_sch]
2022-11-17 Update schematic/Fix DRC issues
    [keyboard_matrix.kicad_sch]
2022-11-17 Move load switch to main sheet
    [keyboard.kicad_sch, led_drive.kicad_sch]
2022-11-17 Update resistor designators to match key designators
    [keyboard.kicad_sch, led_drive.kicad_sch]
2022-11-17 Clean up board and add mounting holes
    [keyboard.kicad_sch, mechanical.kicad_sch]
2022-11-28 Remove old schematic file
    [keyboard.sch]
2022-12-06 Rename switch refdes
    [keyboard.kicad_sch, keyboard_matrix.kicad_sch]
2022-12-07 Working towards SMD LEDs
    [keyboard.kicad_sch, keyboard_matrix.kicad_sch, led_drive.kicad_sch]
2022-12-07 Adding LED symbols
    [keyboard.kicad_sch, keyboard_matrix.kicad_sch]
2022-12-07 Reset refdes for key LEDs
    [keyboard.kicad_sch, keyboard_matrix.kicad_sch]
2024-04-20 Fleshed out layout
    [keyboard.kicad_sch, keyboard_matrix.kicad_sch, led_drive.kicad_sch, mechanical.kicad_sch]
